SepSR/Embedded-Machine-Learning-TinyML-system-designed-for-real-time-predictive-maintenance-of-DC-motors/visualization/confusion_matrix_and_roc.png

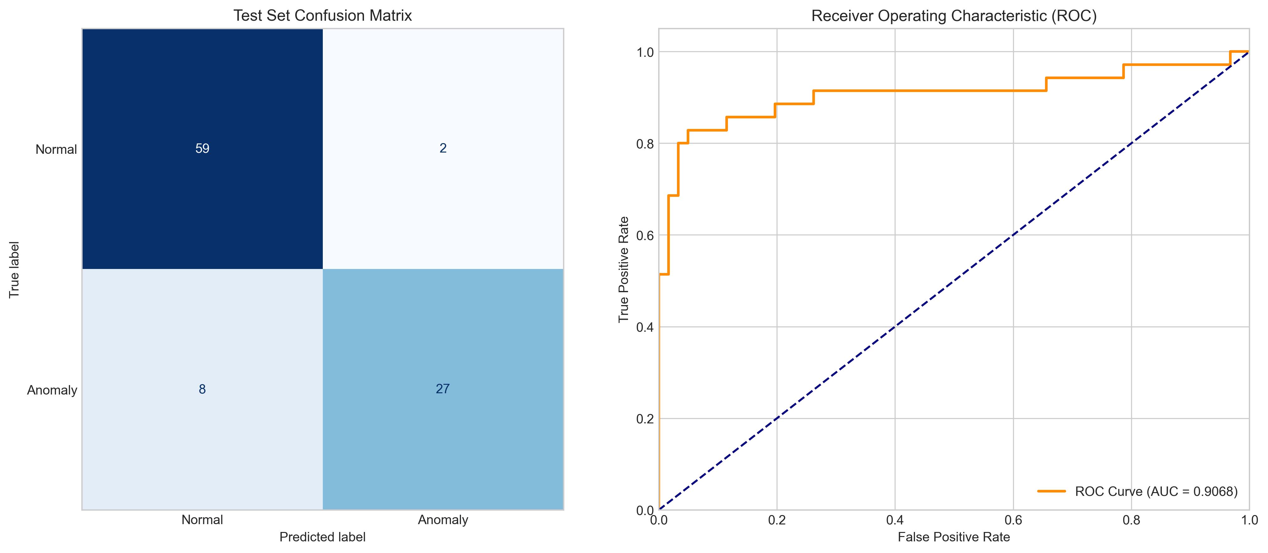
visualization/confusion_matrix_and_roc.png
