SepSR/Embedded-Machine-Learning-TinyML-system-designed-for-real-time-predictive-maintenance-of-DC-motors/visualization/feature_distribution_3d.png

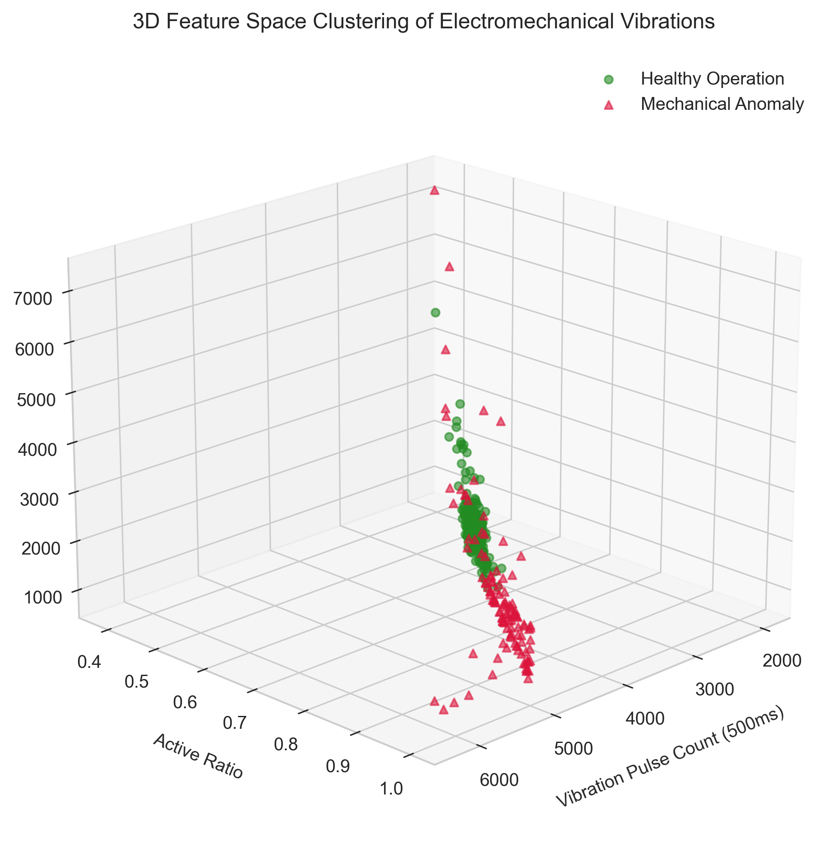
visualization/feature_distribution_3d.png
