SepSR/Embedded-Machine-Learning-TinyML-system-designed-for-real-time-predictive-maintenance-of-DC-motors/visualization/svm_decision_boundary.png

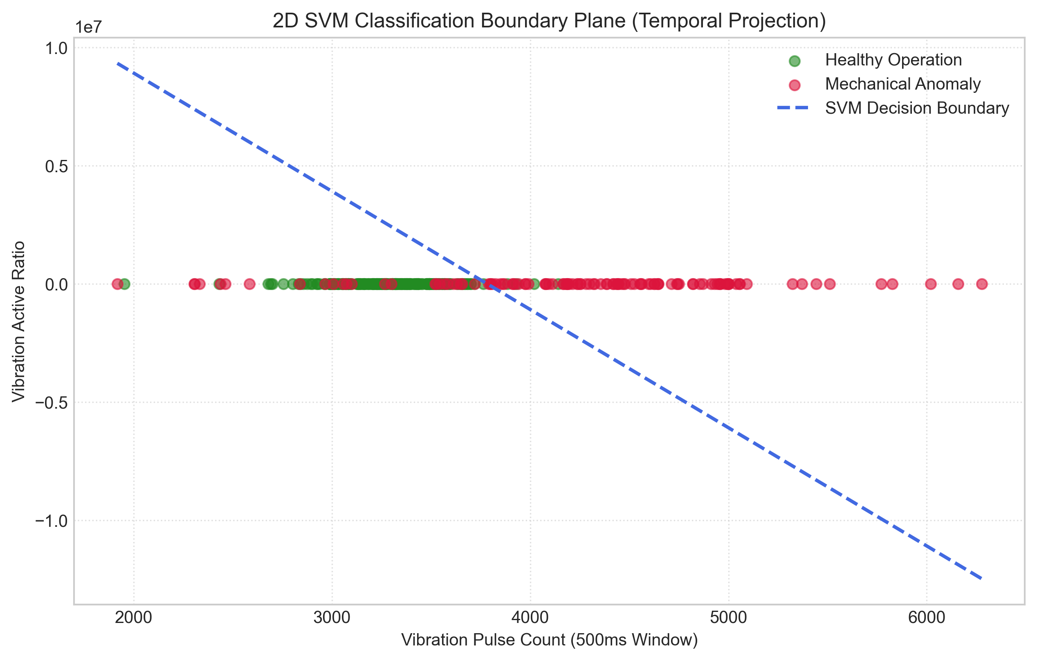
visualization/svm_decision_boundary.png
